mbustosorg/rhb-water-heater/(commit log)

2026-08-19 Port to CircuitPython on the ESP32-S3-ETH, and stop publishing blind
    Replaces the Pico W main.py with code.py on a wired Waveshare
    ESP32-S3-ETH. rhb_pico_utils.py becomes rhb_utils.py.
    Network:
    Configure the interface statically from config["IP"] instead of calling
    set_dhcp(). There is no DHCP server on the wired side, and set_dhcp()
    blocks until it gets a lease that never comes. The installed
    adafruit_wiznet5k takes no response_timeout, so passing one raised
    TypeError and fell through to an unbounded call. Running on the event
    loop, that froze temp_loop too and the device published nothing at all.
    ethernet_connection() is now one immediate, non-blocking attempt; the
    c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
    [t10_socket_bracket.scad]
2026-08-19 Actually receive /pressure: fix the OSC read path
    The monitor's packets were arriving all along -- the socket was open in
    UDP mode on 8888 and the RX buffer was filling -- but nothing was ever
    dispatched. Three faults in the read path, each hiding the next.
    microosc hardcodes a 1ms timeout on the receive socket. Every
    _available() and read_udp() is an SPI transaction to the W5500, so a real
    read cannot finish inside 1ms: it consumed the bytes and then raised
    ETIMEDOUT, which poll() swallows as "no data". Packets were read off the
    chip and thrown away. RX_TIMEOUT gives it room.
    With reads succeeding, poll() then handed its whole buffer to
    recvfrom_into, which keeps calling read_udp unti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
    [code.py]
2026-08-19 Run the bath probe at 9 bit resolution
    The reading is used as whole degrees F, so the library's default 12 bit
    resolves 0.0625C that int() throws away. It costs 750ms of conversion per
    read against 94ms at 9 bit (0.5C), and that conversion is a tight poll of
    a bit-banged OneWire bus with the asyncio loop blocked behind it -- so it
    was also 750ms per cycle in which osc_loop was not polling for /pressure.
    Measured: temp_loop interval 6.0s to 5.1s against a fixed 5s sleep.
    The setting lives in the scratchpad rather than EEPROM, so scan_probes()
    applies it every time the probe is enumerated, including the re-scan that
    recovers from an empty boot-time scan. It also reports how many probes
    wer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
    [code.py]
2026-08-19 Report the pressure link once per connection
    A display that never changes looks identical whether the monitor has gone
    quiet, the link is down, or the read path has stopped dispatching -- which
    is exactly the ambiguity that made the receive fault hard to pin down.
    Log the first /pressure after each connection and then stay silent.
2026-08-19 Document the water heater
    Records what the device owns and publishes, the display layout, the config
    keys, the heater interlock and safety rules, the pin map, and how to deploy
    and read the console.
    Also writes down the things that cost time to rediscover: that set_dhcp()
    hangs on this network, that the ten minute safety check cannot catch a
    temperature that stays flat, that the OneWire CRC errors are physical, and
    that the receive path has to override microosc's socket timeout and buffer
    size or nothing is ever dispatched.
2026-08-20 Pump only: take the heater out of the loop
    Nothing drives heater_pin high any more. It is initialised low and left
    there, and the relay stays in the design so it can come back.
    manage_pump keeps the existing temperature band -- pump on at or below
    LOWER_TEMP, off at or above UPPER_TEMP, hysteretic in between -- and
    /water_heater keeps its name and now carries the pump's state, so
    rhb-sensor-monitor's water_*.csv and the body display need no change.
    The ten minute recycle is gone. It latched a safety shutdown when the bath
    had not warmed after ten minutes of heating, which only made sense while
    something was heating it: with no heater the bath only ever cools, so it
    would have tripped eve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
2026-08-20 Name the output what it is: a solenoid valve
    IO48 drives a solenoid valve, not a pump. The pin and the control logic
    were already right; this is the naming catching up -- valve_pin,
    manage_valve, shutdown_valve, and "Valve open"/"Valve closed" on the
    console.
    There is still a heater in the system, but this board does not control it,
    so IO47 stays undriven. That also means the bath does move across the
    setpoint band under something else's heat, which the previous commit had
    wrong: UPPER_TEMP is reachable and the hysteresis is a real control loop,
    not a one way trip.
    /water_heater keeps its name and carries the valve's state, so
    rhb-sensor-monitor and the body display need no change.
    Veri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
2026-10-27 Blink only the bath digits while the valve is open
    The HT16K33's blink_rate blinks the whole display, pressure digits
    included. blink_loop now toggles at 1 Hz and show_bath_digits blanks
    just digits 2 and 3 on the off beat while the valve is open.
