mbustosorg/rhb-water-heater/(notices)

Notices in the files:
code.py:
Copyright (C) 2024 Mauricio Bustos (m@bustos.org)
it under the terms of the GNU General Public License as published by
